4LyceumPetroupolis/DMS/README.md

# DMS
Drug management system

27 Νοεμβρίου 2018

Προς
Οργανισμό Ανοιχτών Τεχνολογιών – ΕΕΛΛΑΚ
Επιτροπή Πανελλήνιου Διαγωνισμού Εκπαιδευτικής Ρομποτικής & Physical Computing Ανοιχτών Τεχνολογιών

Θέμα: Δήλωση Σημμετοχής στον 1ο Πανελλήνιο Διαγωνισμό Εκπαιδευτικής Ρομποτικής & Physical Computing Ανοιχτών Τεχνολογιών

Αξιότιμα μέλη της ΕΕΛΛΑΚ,

Με την παρούσα επιστολή δηλώνουμε συμμετοχή στον 1ο Πανελλήνιο Διαγωνισμό Εκπαιδευτικής Ρομποτικής & Physical Computing Ανοιχτών Τεχνολογιών.  

Η ιδέα με την οποία η ομάδας μας από το 4ο Γενικό Λύκειο Πετρούπολης θα συμμετάσχει είναι ένας οικιακός αυτόνομος διαχειριστής φαρμάκων (Domestic Automated Drug Management System).  Στόχος μας είναι να δημιουργήσουμε με μία συσκευή που βοηθάει ηλικιωμένους, αλλά και άτομα που χρειάζονται βοήθεια για την σωστή και έγκαιρη λήψη της φαρμακευτικής τους αγωγής.  Με τον τρόπο αυτό θα είναι πιο εύκολο να αποφευχθεί υπερ- ή υπο-δοσολογία φαρμάκων με ότι αυτό μπορεί να συμαίνει για το άτομο που ακολουθεί μία φαρμακευτική αγωγή.

Περισσότερες πληροφορίες παρουσιάζονται στο github της ομάδας μας, 4LyceumPetroupolis/DMS. Η περιγραφή της πρότασης μπορεί να βρεθεί στο αρχείο ProposalDescription-4LyceumPetroupolis.Pdf.

Με εκτίμηση,

Ομάδα 4ου Γενικού Λυκείου Πετρούπολης
