4LyceumPetroupolis/DMS/3D_Mechanical/README.MD

Στον φάκελο αυτό περριέχονται όλα τα αρχεία .stl για την εκτύπωση των μηχανικών τμημάτων για τρισδιάστατη εκτύπωση.
Επίσης το διάγραμμα (3D_Mechanical-System.jpg) του μηχανικού τμήματος αποθήκευσης και διαλογής των χαπιών.
