4LyceumPetroupolis/DMS/Programming/README.md

Ο φάκελος αυτός περιέχει τον κώδικα του DMS.
Επίσης περιέχει οδηγείες για την εγκατάσταση βοηθητικών προγραμμάτων που θα χρειαστείτε για την πλήρη λειτουργία του συστήματος.
Για παράδειγμα, δείνονται οδηγείες για την εγκατασταση τοy driver της οθόνης, και διαφόρων modules του python, 
απαραίτητα για την εκτέλεση του προγράμματος.
