4LyceumPetroupolis/DMS/ΚΑΤΑΛΟΓΟΣ ΥΛΙΚΩΝ.pdf

Προϊόν | Website | Προμηθευτής | SKU | Ποσότητα | Τιμή | Μερικό Σύνολο | Σχόλια
Raspberry Pi 3 - Model B+ | https://grobotronics.com/ra spberry-pi-3-model-b-el.html | GRobotronics | 06-00012933 | 1 | € 41.90 | € 41.90
Power Supply 5V 2.5A - Raspberry Pi Official (White) | https://grobotronics.com/5v-2.5a-raspberry-pi.html?sl=el (https://grobotronics.com/5v-2.5a-raspberry-pi.html?sl=el) | GRobotronics | 06-00005875 | 1 | € 9.90 | € 9.90 | Τροφοδοτικό για Raspberry
Micro SD 16GB - Pre-Loaded with NOOBS | https://grobotronics.com/mi cro-sd-16gb-pre-loaded-with-noobs.html | GRobotronics | 06-00014012 | 1 | € 13.90 | € 13.90 | Memory card for Raspberry
Pi Display 4.3" HDMI 480x272 Resistive Touchscreen | https://grobotronics.com/pi-display-4.3-hdmi-480x272-resistive-touchscreen.html (https://grobotronics.com/pi-display-4.3-hdmi-480x272-resistive-touchscreen.html) | GRobotronics | 31-00011865 | 1 | € 41.90 | € 41.90 | Screen
Stepper Motor - 0.35kg.cm 5V | https://grobotronics.com/st epper-motor-0.35kg.cm.html (https://grobotronics.com/stepper-motor-0.35kg.cm.html) | GRobotronics | 19-00012858 | 4 | € 2.50 | € 10.00 | stepper motor driver, ULN2003
Stepper Driver Breakout - ULN2003 | https://grobotronics.com/st epper-driver-breakout-uln2003.html (https://grobotronics.com/stepper-driver-breakout-uln2003.html) | GRobotronics | 19-00000088 | 4 | € 1.90 | € 7.60 | stepper motor driver, ULN2003
Flora Lux Sensor - TSL2561 Light Sensor -v1.0 | https://grobotronics.com/fl ora-lux-sensor-tsl2561-light-sensor-v1.0.html | GRobotronics | 09-00001246 | 1 | € 8.33 | € 8.33 | Light sensor for counting pills
HDMI to HDMI Flat Cable 30cm | https://grobotronics.com/hd mi-hdmi-flat-30cm.html (https://grobotronics.com/hdmi-hdmi-flat-30cm.html) | GRobotronics | 19-00012197 | 1 | € 2.90 | € 2.90 | HDMI cable
Adafruit PCF8523 Real Time Clock Assembled Breakout Board | https://grobotronics.com/ad afruit-pcf8523-real-time-clock-assembled-breakout-board.html (https://grobotronics.com/adafruit-pcf8523-real-time-clock-assembled-breakout-board.html) | GRobotronics | 09-00003295 | 1 | € 6.40 | € 6.40 | Reak time clo k
Rocker Switch -Round w/ Green LED | https://grobotronics.com/ro cker-switch-round-w-green-led.html (https://grobotronics.com/rocker-switch-round-w-green-led.html) | GRobotronics | 29-00015001 | 1 | € 0.80 | € 0.80 | On/Off swith

AC Power Jack 230V 6.3mm Connectors https://grobotronics.com/acpower-jack-230vstraight.html (https://grobotronics.com/ac-power-jack-230v-straight.html)

GRobotronics | 05-00085947 | 1 | € 0.80 | € 0.80
AC power
Power Supply Cable AC 250V 1.8m | https://grobotronics.com/ac-250v-1.8m.html (https://grobotronics.com/ac-250v-1.8m.html) | GRobotronics | 05-00031107 | 1 | € 3.40 | € 3.40 | Power cable
Jumper Wires 15cm Female to Male - Pack of 10 | https://grobotronics.com/ju mper-wires-15cm-female-to-male-pack-of-10.html | GRobotronics | 11-00015553 | 2 | € 1.80 | € 3.60 | jumper wires for prototyping
Jumper Wires 15cm Female to Female - Pack of 10 | https://grobotronics.com/ju mper-wires-15cm-female-to-female-pack-of-10.html | GRobotronics | 11-00015551 | 2 | € 1.80 | € 3.60 | jumper wires for prototyping
Breadboard Jumper Wires 140Pcs (Bulk) | https://grobotronics.com/br eadboard-jumper-wires-140pcs-bulk.html | GRobotronics | 19-00014101 | 1 | € 2.90 | € 2.90 | wires
Jumper Wires 15cm Male to Male - Pack of 10 | https://grobotronics.com/ju mper-wires-15cm-male-to-male-pack-of-10.html | GRobotronics | 11-00015552 | 1 | € 1.80 | € 1.80 | jumper wires for prototyping
Pin Header 1x10 Male 2mm (Xbee) | https://grobotronics.com/pi n-header-1x10-male-2mm-xbee.html (https://grobotronics.com/pin-header-1x10-male-2mm-xbee.html) | GRobotronics | 05-00011914 | 4 | € 0.10 | € 0.40 | header
Molex Connector Female 2-Pin 2.54mm | https://grobotronics.com/m olex-connector-female-2-pin-2.54mm.html (https://grobotronics.com/molex-connector-female-2-pin-2.54mm.html) | GRobotronics | 05-00250200 | 4 | € 0.03 | € 0.12 | connector
Alligator Test Leads - Multicolored 10 Pack | https://grobotronics.com/all igator-test-leads-multicolored-10-pack.html (https://grobotronics.com/alligator-test-leads-multicolored-10-pack.html) | GRobotronics | 11-00015570 | 2 | € 3.00 | € 6.00
Standoff M2.5 Plastic M/F L20mm | https://grobotronics.com/st and-off-plastic-m2.5-m-f-20mm.html (https://grobotronics.com/stand-off-plastic-m2.5-m-f-20mm.html) | GRobotronics | 05-00025818 | 15 | € 0.20 | € 3.00
Bolt M3 - L6mm DΙΝ965 Black | https://grobotronics.com/bo lt-m3-6mm-din-965.html | GRobotronics | 05-00059611 | 20 | € 0.03 | € 0.60
Bolt M3 - L25mm DIN965 Black | https://grobotronics.com/bo lt-m3-25mm-din-965.html (https://grobotronics.com/bolt-m3-25mm-din-965.html) | GRobotronics | 05-00059619 | 20 | € 0.05 | € 1.00

Nut M3 Metal | https://grobotronics.com/nu
Raspberry Pi 2/3 Square Case Transparent | https://grobotronics.com/ra spberry-pi-2-3-square-case-transparent.html | GRobotronics | 19-00010982 | 1 | € 3.60 | € 3.60
Fan 30x30x10mm 5V for Raspberry Pi Case | https://grobotronics.com/fa n-30x30x10mm-5v-for-raspberry-pi-case.html | GRobotronics | 19-00090170 | 1 | € 2.60 | € 2.60
T-Cobbler Plus - GPIO Breakout for Raspberry Pi 3 / 2 / B+ | https://grobotronics.com/t-cobbler-plus-gpio-breakout-for-raspberry-pi-3-2-b.html | GRobotronics | 19-00012554 | 1 | € 3.90 | € 3.90
Raspberry Pi Heatsink - Silver (Set of 3) | https://grobotronics.com/ra spberry-pi-heatsink-silver-set-of-3.html | GRobotronics | 19-00012923 | 1 | € 1.20 | € 1.20
GPIO Ribbon Cable for Raspberry Pi 3 / 2 / B+ | https://grobotronics.com/gp io-ribbon-cable-for-raspberry-pi-3-2-b.html | GRobotronics | 11-00022123 | 1 | € 2.00 | € 2.00
t-m3-metal.html | GRobotronics | 05-00030099 | 100 | € 0.01 | € 0.81
Γενικό Σύνολο | € 184.96

GRobotronics
Τηλ κέντρο παραγγελιών: 801-300-3626 Τηλ: 2118004320 (από κινητό)
Fax: 2118004319
Φυσικό Μαγαζί: 2118002019
Info: info@grobotronics.com
Sales: sales@grobotronics.com
Support: support@grobotronics.com
Headquarters: 328 Vouliagmenis Ave., Agios Dimitrios, 17342, Greece
