4LyceumPetroupolis/DMS/Photos_and_Video/README.MD

Ένα youtube βίντεο με τις διάφορες φάσεις της κατασκευής και υλοποίησης του μηχανήματος και την παρουσίαση του τρόπου λειτουργίας του φαίνεται στην διεύθυνση: https://youtu.be/6HDDZlzJQho
