4LyceumPetroupolis/DMS/3D_Mechanical/3D_Mechanical-System.jpg

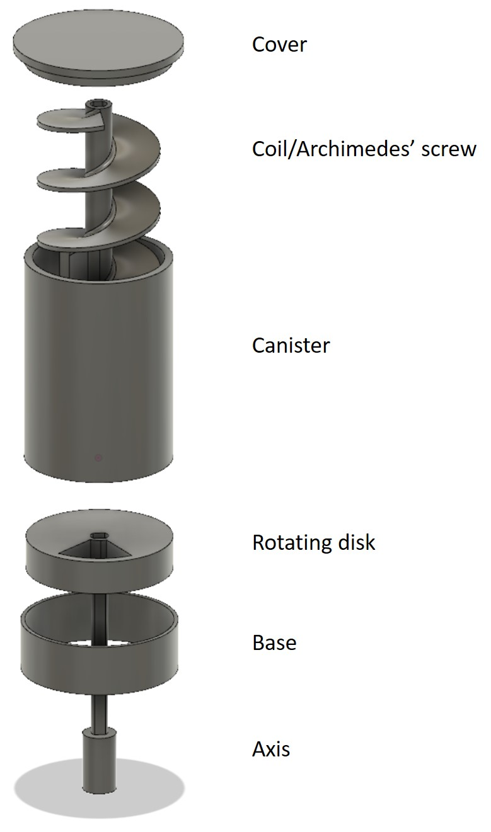
3D_Mechanical/3D_Mechanical-System.jpg
