4LyceumPetroupolis/DMS/3D_Mechanical/3D_DiskForSmallPills.stl

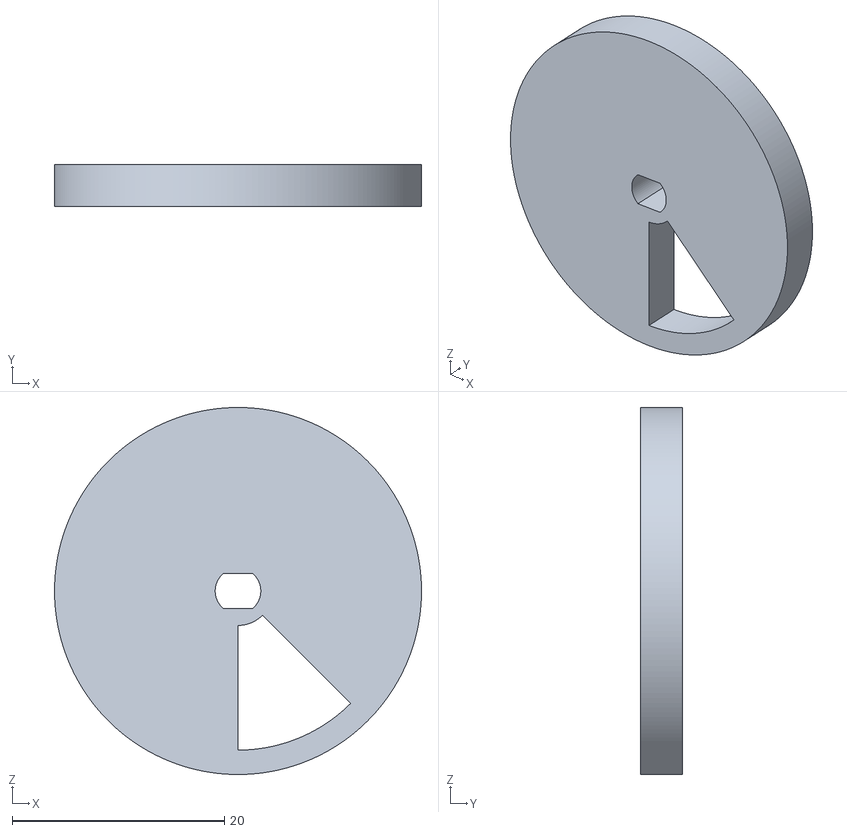
[picture p8: CAD file, 2019-05-05]
3D_Mechanical/3D_DiskForSmallPills.stl
34.6 x 4.00 x 34.6
