4LyceumPetroupolis/DMS/3D_Mechanical/3D_CanisterLargeForLargePills.stl

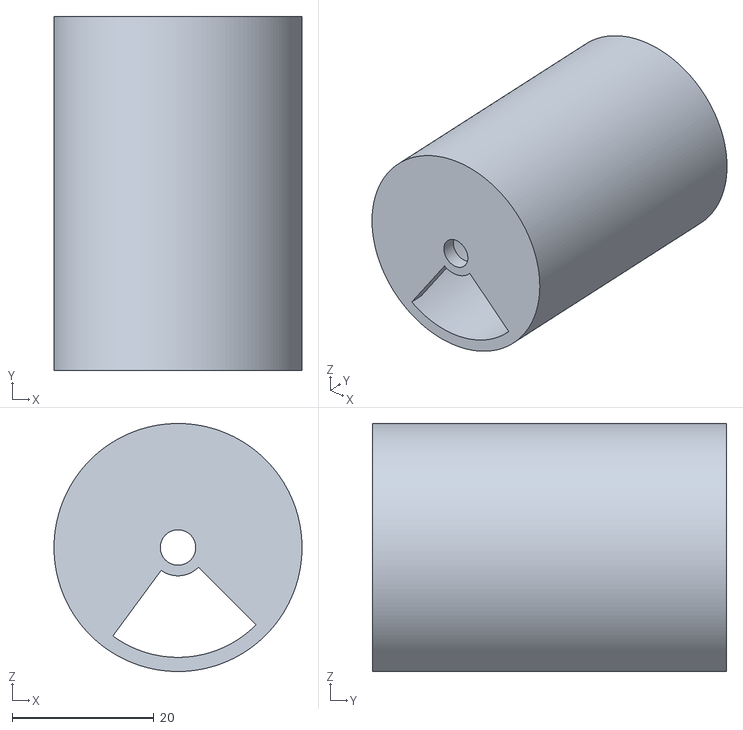
[picture p9: CAD file, 2019-05-05]
3D_Mechanical/3D_CanisterLargeForLargePills.stl
35.0 x 50.0 x 35.0
