4LyceumPetroupolis/DMS/3D_Mechanical/3D_cap.stl

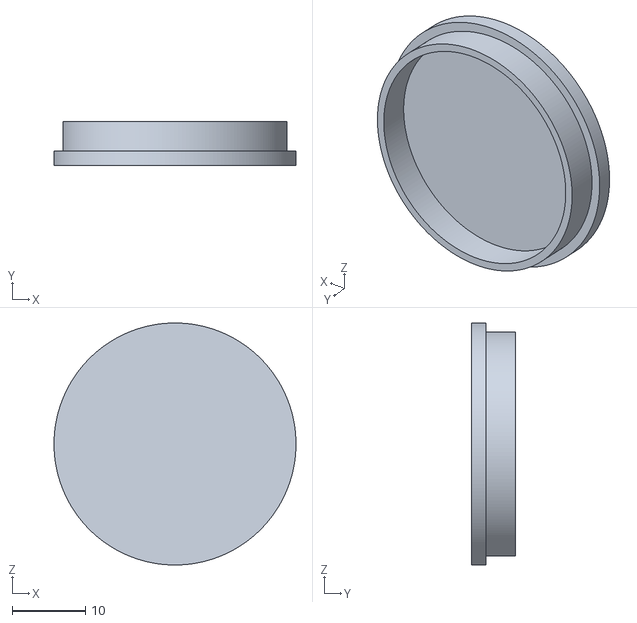
[picture p10: CAD file, 2019-05-05]
3D_Mechanical/3D_cap.stl
33.0 x 6.00 x 33.0
