4LyceumPetroupolis/DMS/3D_Mechanical/3D_DiskForLargePills.stl

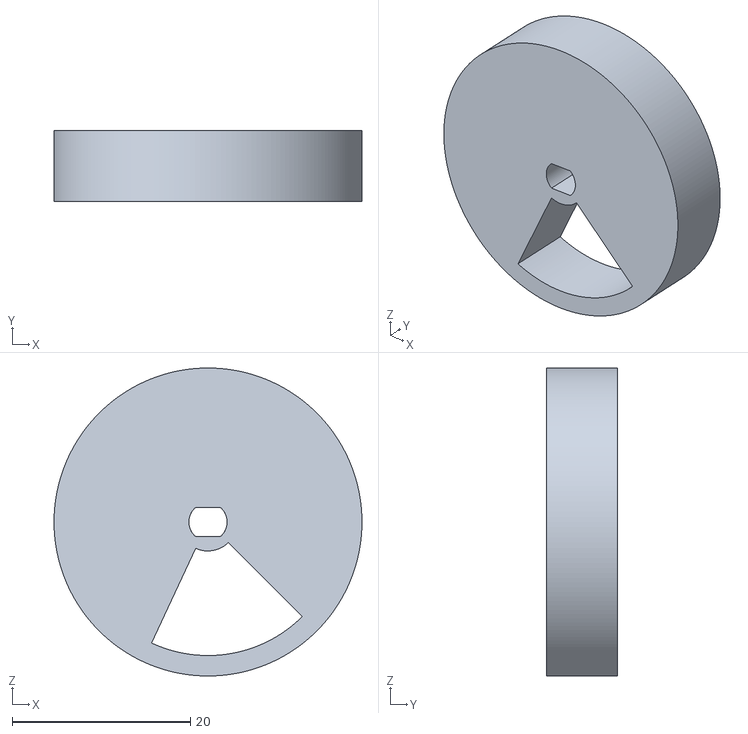
[picture p11: CAD file, 2019-05-05]
3D_Mechanical/3D_DiskForLargePills.stl
34.6 x 8.00 x 34.6
