4LyceumPetroupolis/DMS/3D_Mechanical/3D_Base.stl

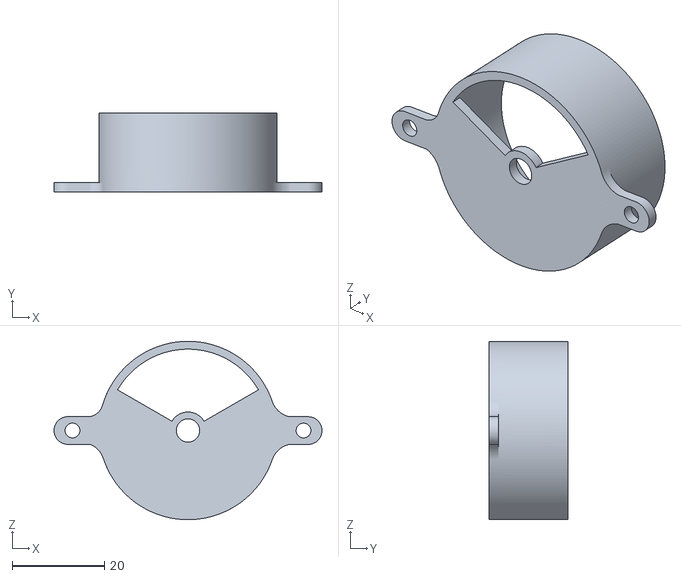
[picture p12: CAD file, 2019-05-05]
3D_Mechanical/3D_Base.stl
58.0 x 17.0 x 38.6
