4LyceumPetroupolis/DMS/3D_Mechanical/3D_Coil.stl

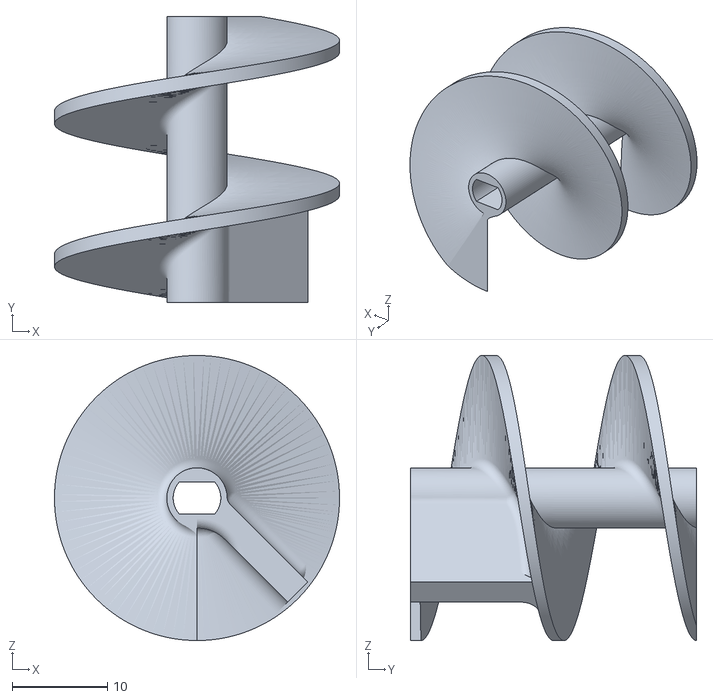
[picture p13: CAD file, 2019-05-05]
3D_Mechanical/3D_Coil.stl
29.9 x 30.0 x 29.9
