4LyceumPetroupolis/DMS/3D_Mechanical/3D_Axis.stl

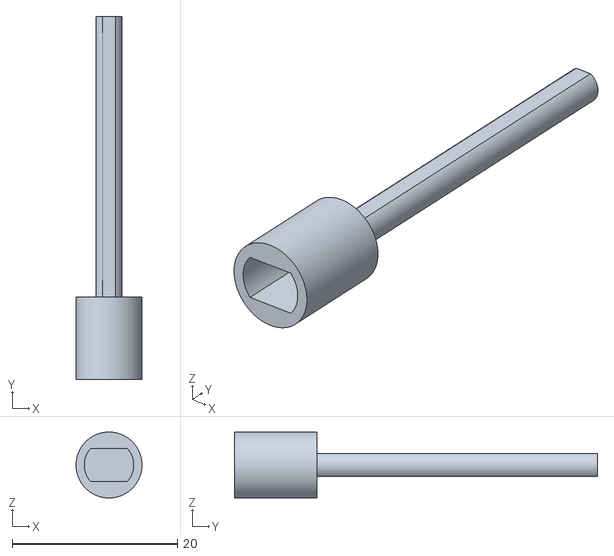
[picture p14: CAD file, 2019-05-05]
3D_Mechanical/3D_Axis.stl
8.00 x 44.0 x 8.00
