4LyceumPetroupolis/DMS/(list of files, cad)

Other CAD files:
3D_Mechanical/3D_CanisterForSmallPills.stl
